lvdopqt/4-channel-player/assets/4ch-player-schematic.pdf

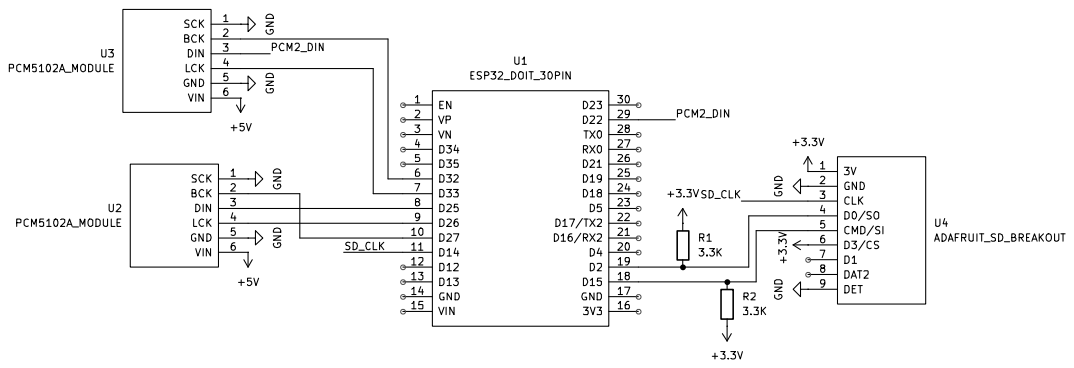
[picture p1: page 1]
