lvdopqt/4-channel-player/(commit log)

2026-07-01 feat: add schematics
2026-07-01 Fix wiring schematics link in README
    Updated the link to the wiring schematics drawing in the README.
2026-07-21 feat: adjust schematic and readme
